VK3JST/Track-hold-VFO/Photo 1 - Nano modules - ceramic vs quartz.jpg

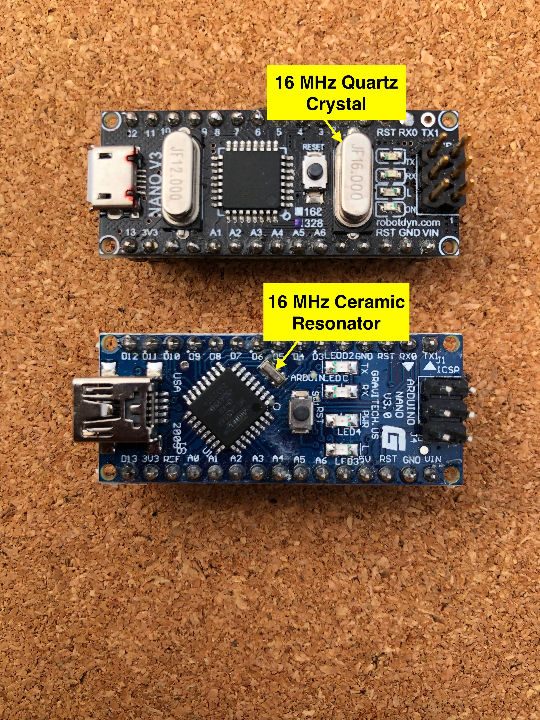
Photo 1 - Nano modules - ceramic vs quartz.jpg
