VK3JST/Track-hold-VFO/Photo 3 - Uno module underside - resistor added.jpg

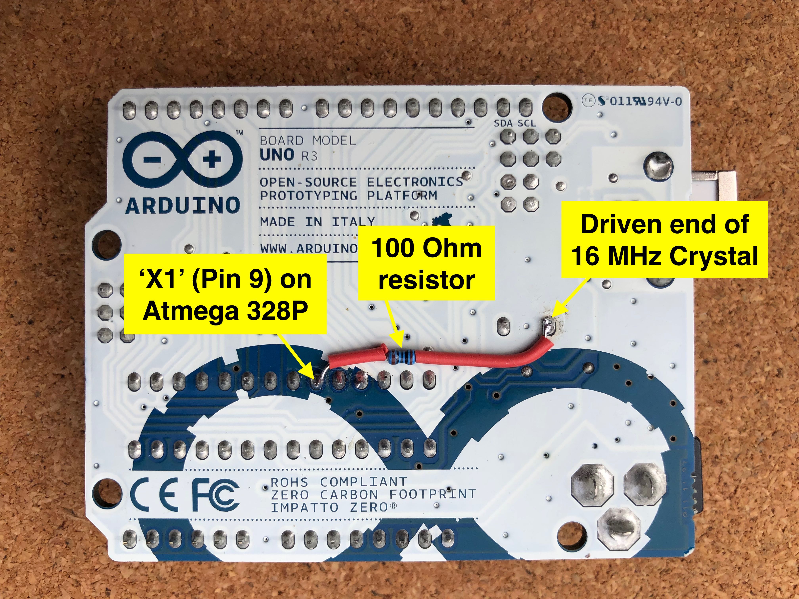
Photo 3 - Uno module underside - resistor added.jpg
