VK3JST/Track-hold-VFO/Photo 2 - Uno module - 16MHz resonator removed.jpg

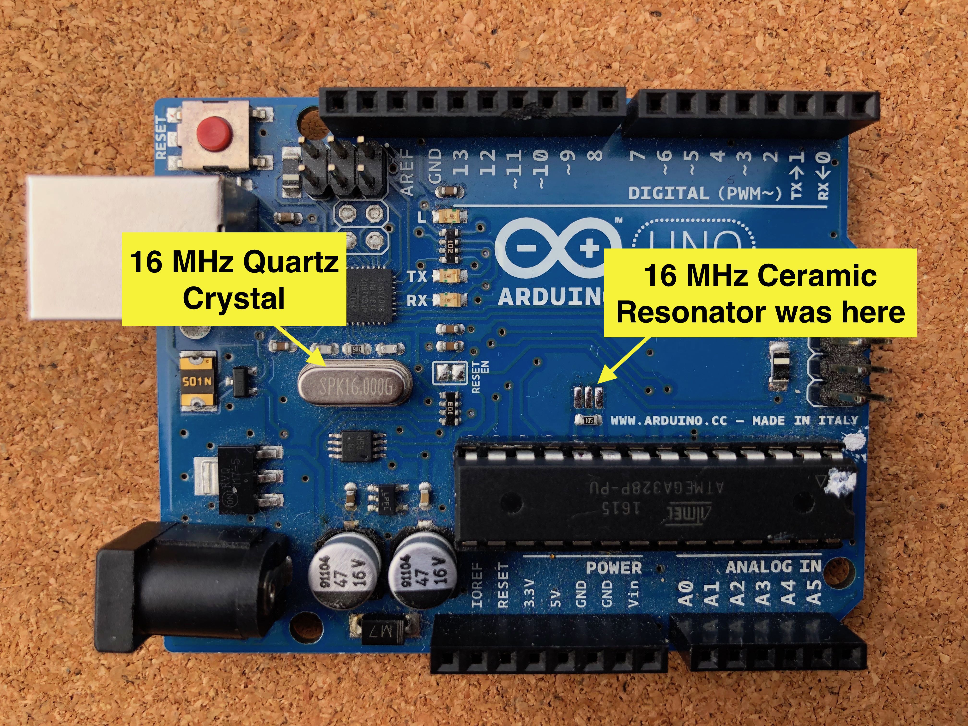
Photo 2 - Uno module - 16MHz resonator removed.jpg
