VK3JST/Track-hold-VFO/Photo 4 - VFO with new PCB.jpg

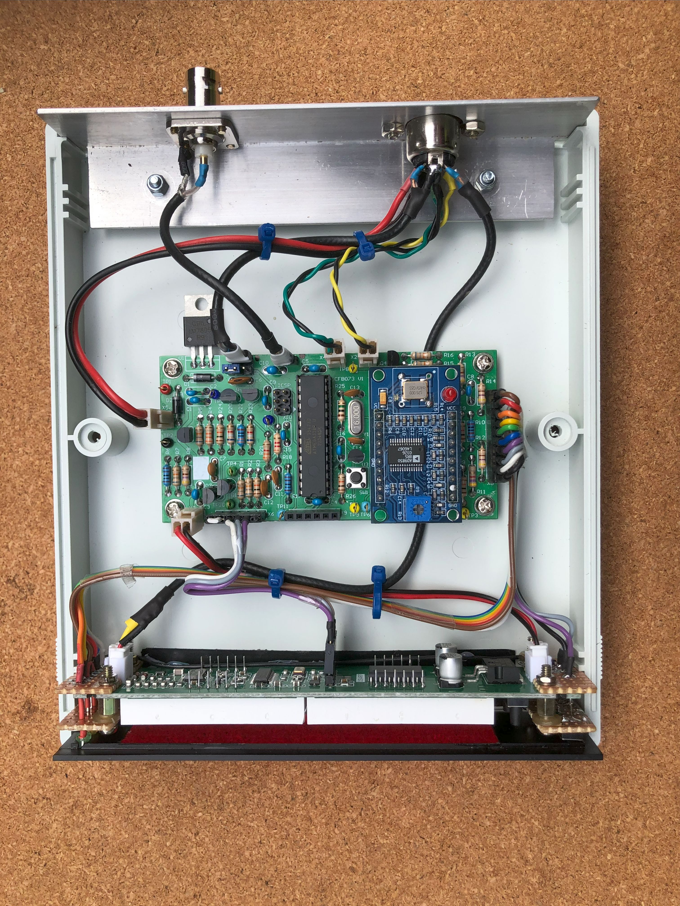
Photo 4 - VFO with new PCB.jpg
